jmitz/piZeroCanEnclosure/viewer/models/base-e8e8ea.stl

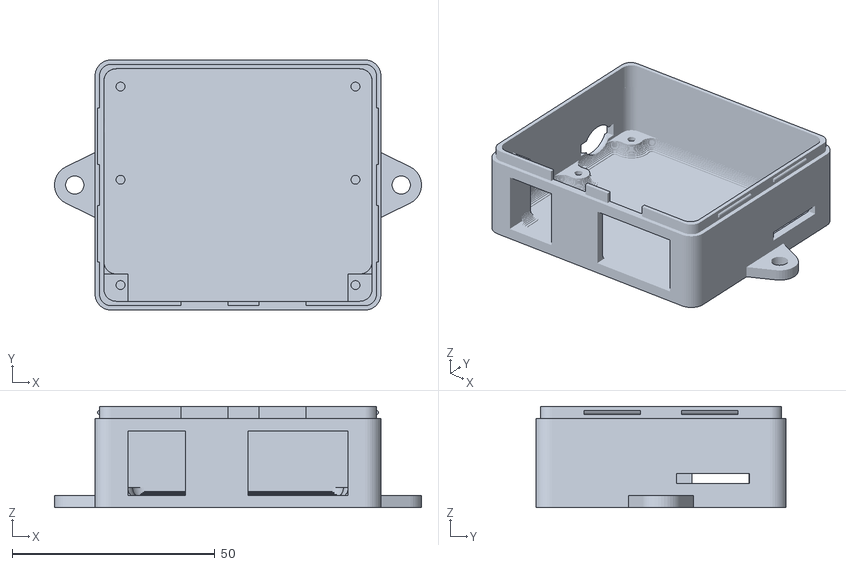
[picture p1: CAD file, 2026-11-05]
viewer/models/base-e8e8ea.stl
90.6 x 61.8 x 25.0
