jmitz/piZeroCanEnclosure/viewer/models/lid-e8e8ea.stl

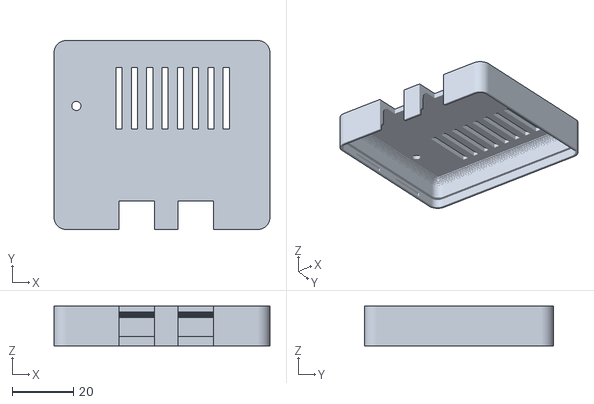
[picture p2: CAD file, 2026-11-05]
viewer/models/lid-e8e8ea.stl
70.6 x 61.8 x 13.1
