jmitz/piZeroCanEnclosure/viewer/models/hat-2fa24a.stl

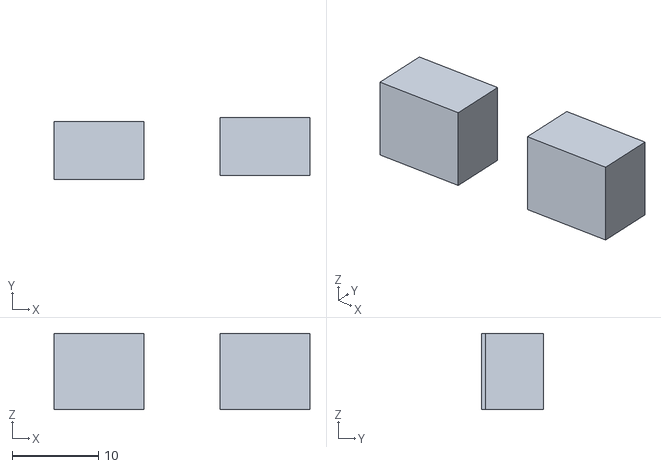
[picture p3: CAD file, 2026-11-04]
viewer/models/hat-2fa24a.stl
29.6 x 7.20 x 8.80
