jmitz/piZeroCanEnclosure/viewer/models/zero-c8c8c8.stl

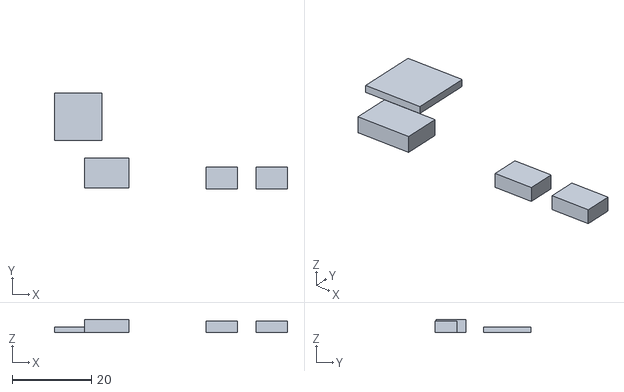
[picture p4: CAD file, 2026-11-04]
viewer/models/zero-c8c8c8.stl
58.8 x 24.2 x 3.20
