jmitz/piZeroCanEnclosure/viewer/models/hat-111.stl

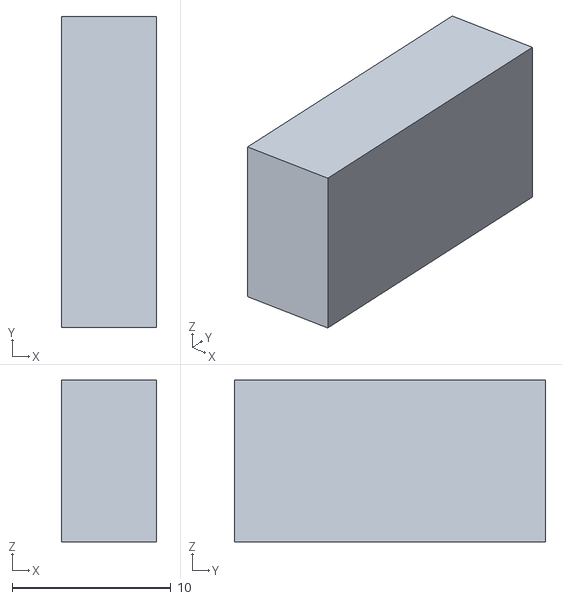
[picture p5: CAD file, 2026-11-04]
viewer/models/hat-111.stl
6.00 x 19.6 x 10.2
