jmitz/piZeroCanEnclosure/viewer/models/zero-e8e0c8.stl

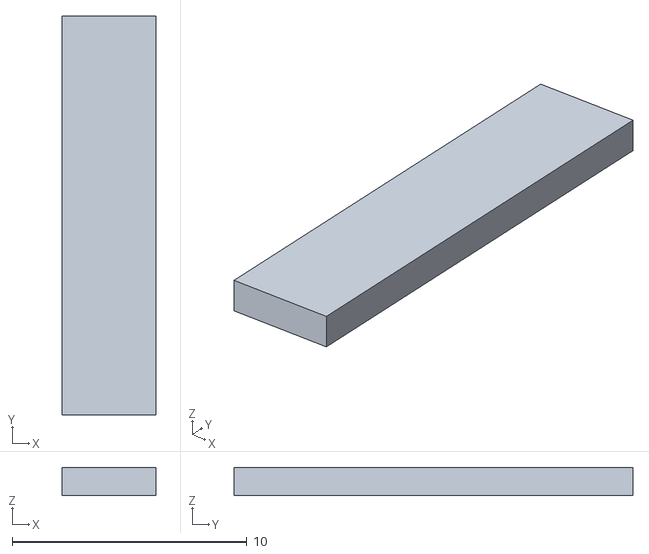
[picture p6: CAD file, 2026-11-04]
viewer/models/zero-e8e0c8.stl
4.00 x 17.0 x 1.20
