jmitz/piZeroCanEnclosure/viewer/models/hat-1b4fa0.stl

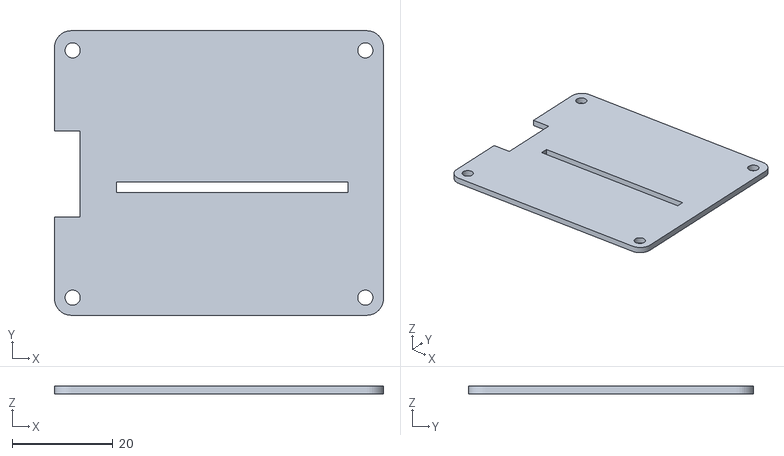
[picture p7: CAD file, 2026-11-04]
viewer/models/hat-1b4fa0.stl
65.2 x 56.4 x 1.60
