jmitz/piZeroCanEnclosure/viewer/models/plugs-1a1a1a.stl

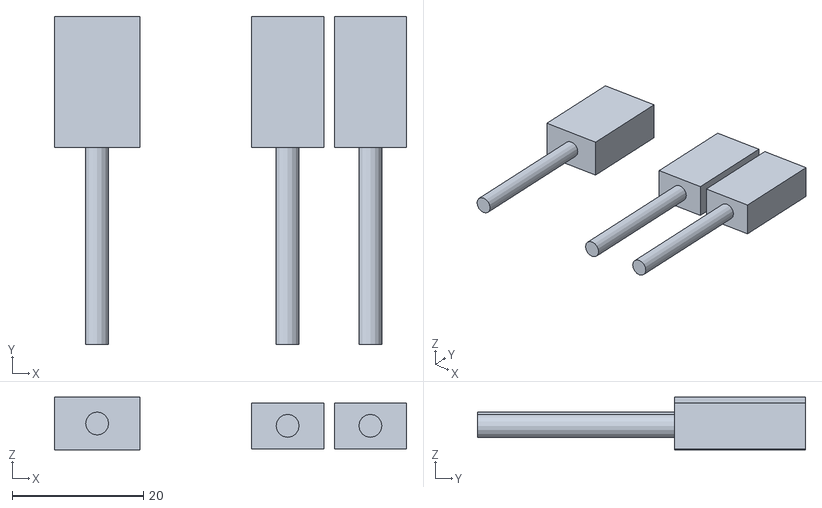
[picture p8: CAD file, 2026-11-04]
viewer/models/plugs-1a1a1a.stl
53.6 x 50.0 x 8.00
