jmitz/piZeroCanEnclosure/viewer/models/hat-222.stl

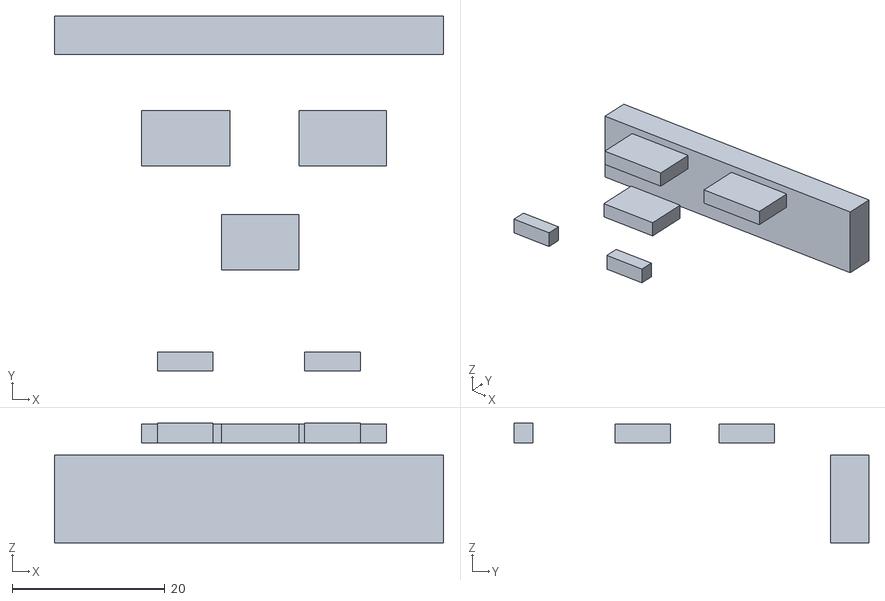
[picture p9: CAD file, 2026-11-04]
viewer/models/hat-222.stl
51.0 x 46.5 x 15.7
