jmitz/piZeroCanEnclosure/viewer/models/plugs-999.stl

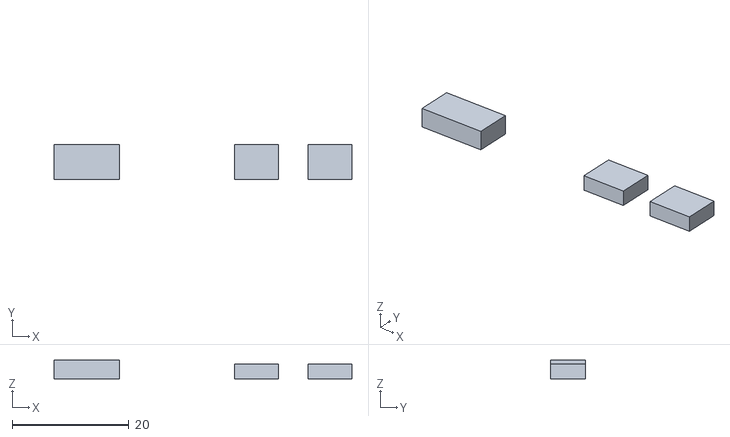
[picture p10: CAD file, 2026-11-04]
viewer/models/plugs-999.stl
51.0 x 6.00 x 3.20
