jmitz/piZeroCanEnclosure/viewer/models/zero-111.stl

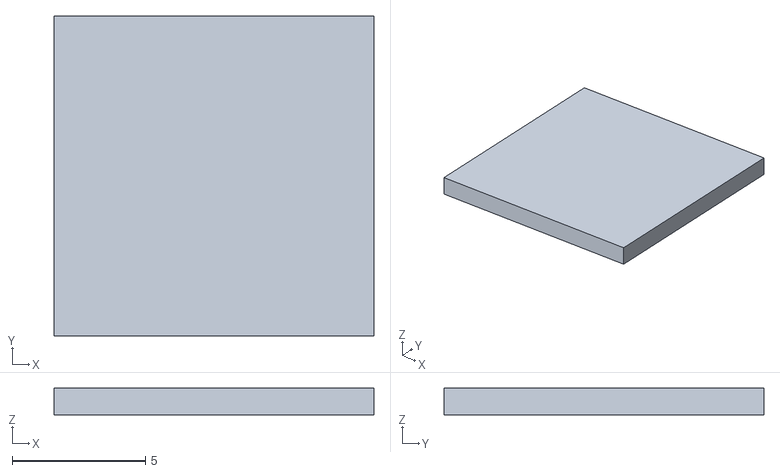
[picture p11: CAD file, 2026-11-04]
viewer/models/zero-111.stl
12.0 x 12.0 x 1.00
