jmitz/piZeroCanEnclosure/viewer/models/zero-1f7a4d.stl

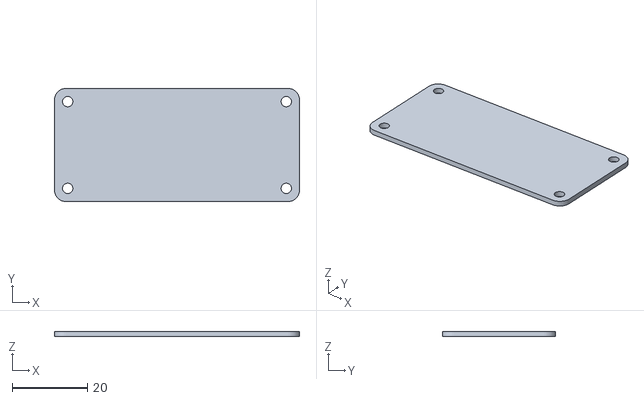
[picture p12: CAD file, 2026-11-04]
viewer/models/zero-1f7a4d.stl
65.0 x 30.0 x 1.40
