jmitz/piZeroCanEnclosure/viewer/models/hat-e6c200.stl

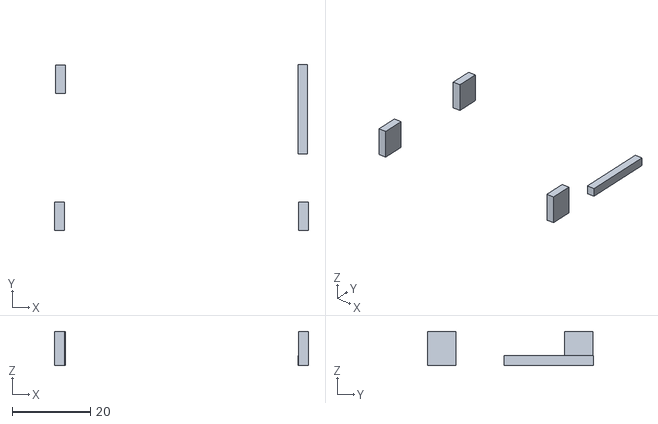
[picture p13: CAD file, 2026-11-04]
viewer/models/hat-e6c200.stl
64.8 x 42.3 x 8.70
