jmitz/piZeroCanEnclosure/viewer/models/zero-444.stl

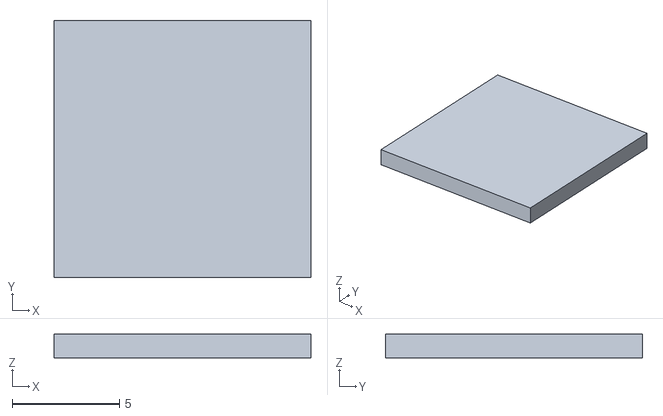
[picture p14: CAD file, 2026-11-04]
viewer/models/zero-444.stl
12.0 x 12.0 x 1.10
