jmitz/piZeroCanEnclosure/viewer/models/zero-222.stl

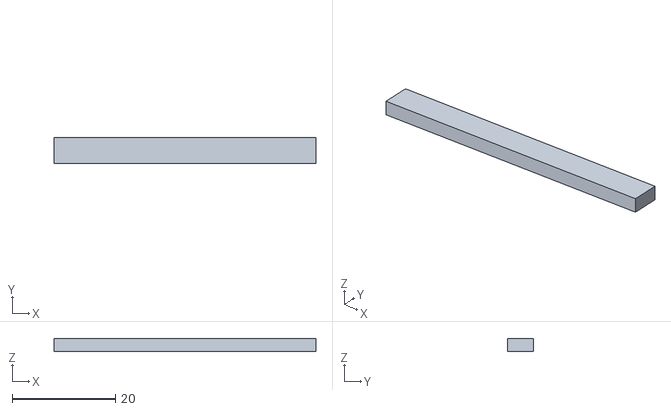
[picture p15: CAD file, 2026-11-04]
viewer/models/zero-222.stl
50.8 x 5.08 x 2.50
