jmitz/piZeroCanEnclosure/viewer/models/hat_screws-c8c8c8.stl

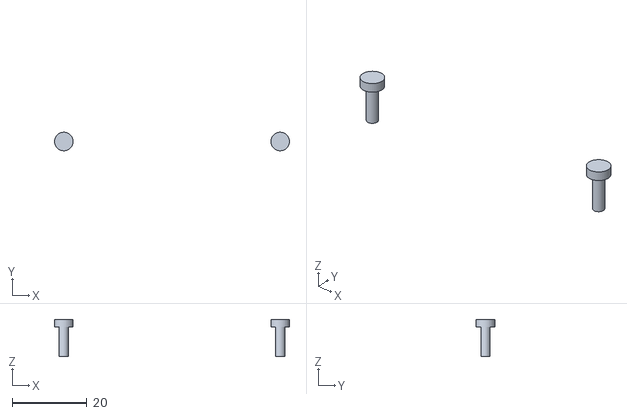
[picture p16: CAD file, 2026-11-04]
viewer/models/hat_screws-c8c8c8.stl
63.0 x 5.00 x 10.0
