jmitz/piZeroCanEnclosure/viewer/models/zero_screws-c8c8c8.stl

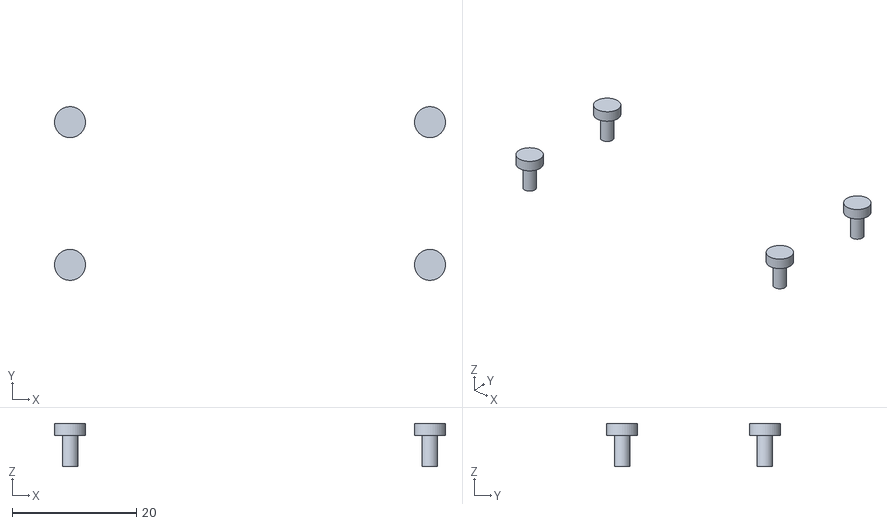
[picture p17: CAD file, 2026-11-04]
viewer/models/zero_screws-c8c8c8.stl
63.0 x 28.0 x 7.00
