jmitz/piZeroCanEnclosure/(commit log)

2026-11-04 Add Pi Zero W CAN HAT enclosure and WebXR viewer
    OpenSCAD model of a two-part, screwless enclosure for a Raspberry Pi
    Zero W with a Waveshare 2-CH CAN HAT, using dimensions from the official
    Pi drawing and Waveshare's STEP file. Includes a WebXR viewer served over
    HTTPS so the model can be opened in the Quest Browser.
    [base-e8e8ea.stl, enclosure.scad, hat-111.stl, hat-1b4fa0.stl, hat-222.stl, hat-2fa24a.stl, hat-e6c200.stl, lid-e8e8ea.stl]
2026-11-04 Add README
    Covers the enclosure design, printing, rebuilding the model, and setting
    up the WebXR viewer, including the certificate and firewall steps.
2026-11-04 Add pin test prints and show them in the viewer
    Adds a diameter ladder for trying pin sizes in the real board holes and
    a walls-free frame with all six pins at their true positions and heights.
    The viewer gains three views for them, and the README covers how to use
    the prints and now records that the viewer has been used on a real Quest.
    [pin_fit.stl, pin_layout.stl, test_prints.scad]
2026-11-04 Replace printed pins with screws
    The printed pins were too weak. The boards now use M2.5 self-tapping
    screws in blind pilot holes, at the positions and 14 mm gap confirmed by
    the location test print. The lid keeps hold-downs only at the unscrewed
    GPIO end. The pin test prints are removed, and the viewer shows the screws.
    [base-e8e8ea.stl, enclosure.scad, hat_screws-c8c8c8.stl, lid-e8e8ea.stl, pin_fit.stl, pin_layout.stl, test_prints.scad, zero_screws-c8c8c8.stl]
2026-11-05 Fillet the enclosure walls and remove the lid pins
    The first print was fragile where the walls met the floor and top. Add a
    3 mm fillet at those joins, the inside corners and around the posts, and
    extend the cable openings so the fillets don't block the plugs.
    The lid's hold-down tubes aren't needed, so remove them.
    [base-e8e8ea.stl, enclosure.scad, lid-e8e8ea.stl]
